valves-ops/gasoline-adulteration-detector/relatorio.pdf

# Universidade Federal de Santa Catarina

## Departamento de Engenharia Elétrica e Eletrônica

### EEL7837 - Projeto Nível I em Eletrônica II

# Detector de Gasolina Adulterada

Aluno | Vinícius D. Alves | 14100702

Professor Jefferson Luiz Brum Marques

21 de Setembro de 2020

## Conteúdo

1 Introdução | 1
2 Descrição do Projeto | 2
3 Fundamentação Teórica | 3
3.1 Fundamentos da determinação da composição de substâncias por proprie-
4 Projeto do Dispositivo | 7
4.2.2 | Redução do Impacto do Ruído de Quantização por meio de Elemen-
5 Resultados e Trabalhos Futuros | 21
6 Apêndice | 23
Referências | 27

## 1 Introdução

Estima-se que só em São Paulo 7% dos postos adulteram a gasolina que vendem [4]. Mesmo com uma fiscalização mais incisiva, os fraudadores ainda conseguem praticar o ato graças a adoção de tecnologias mais sofisticadas, como os chips que permitem de maneira remota a seleção entre a gasolina adulterada e a formulada [9]. Os danos provocados pela gasolina adulterada variam desde a perda de performance e dificuldade em partir o motor do carro até a corrosão e entupimento de componentes do sistema de injeção que podem causar grandes prejuízos para o proprietário do veículo [4]. Dado esse cenário, e a onda de combate a corrupção que tomou o país nos últimos anos, creio que munir o consumidor com uma tecnologia que o permita auditar a gasolina que compra de forma ágil e econômica seja a maneira mais eficiente, uma vez que não depende do Estado e de seus inumeráveis órgãos de fiscalização, de combater essa forma de corrupção praticada por postos de gasolina.
Dentre desse contexto, esse projeto tem como propósito o desenvolvimento do protótipo de um dispositivo capaz de efetuar a verificação do conteúdo de etanol de amostras de gasolina.

## 2 Descrição do Projeto

Objetiva-se por meio desse projeto a pesquisa, desenvolvimento e implementação do protótipo de um dispositivo portátil e de fácil uso que seja capaz de inferir o teor alcoólico de uma amostra de gasolina e, assim, determinar se essa encontra-se dentro dos requisitos da legislação.
O dispositivo explora a diferença de resistividade da gasolina e do etanol, o que implica em diferentes resistividades para soluções com diferentes proporções de etanol e gasolina. Para efetuar a medição da resistência da solução, o dispositivo é constituído por uma sonda de geometria padrão, o que torna as resistências medidas comparáveis, eliminandose a necessidade de calcular-se a resistividade a partir da resistência mensurada. Através da sonda citada, o fluído é excitado com uma tensão alternada gerada por módulo excitador e a diferença de tensão sobre o fluído é medida pelo módulo medidor. Esse, por sua vez, coleta amostras que são filtradas, processadas e alimentam uma função interpolante que descreve a relação entre a concentração volumétrica de etanol e a resistência medida. O resultado do cálculo da função é a concentração volumétrica de etanol da solução sob teste, que, quando comparado com o especificado na legislação, determina se a solução está ou não adulterada.
Para comprovar o funcionamento do dispositivo irá comparar-se o resultado de suas medidas com o procedimento clássico de extração da fase aquosa do sistema heterogêneo água-etanol-gasolina.

## 3 Fundamentação Teórica

### 3.1 Fundamentos da determinação da composição de substâncias por propriedades elétricas

A determinação da constituição de um material é feita a partir de suas propriedades intensivas [8], tais como densidade, dureza e índice de reflexão. No domínio eletromagnético, materiais podem ser caracterizados por propriedades como resistividade, permitividade e permissividade, isto é, ao medir-se a impedância de um material e calcular-se sua resistividade, permitividade e permissividade características, levando-se em conta sua geometria, é possível distinguir o material em questão de outros que apresentem diferentes características eletromagnéticas. Evidentemente que materiais podem compartilhar características eletromagnéticas e ainda sim serem classificados como materiais diferentes, sendo a diferenciação provocada por características num domínio diverso, tal como o mecânico ou o óptico.
Aplicações deste conceito podem ser encontradas nas mais diversas áreas da ciência, destacam-se dois exemplos: a mensuração da composição corporal através da bioimpedância e a inferência do conteúdo geológico do solo através do método da eletro-resistividade.
A técnica de bioimpedância explora a diferença de condutividade entre tecidos, isto é, tecidos com maior disponibilidade de eletrólito, como o tecido muscular, apresentam menor resistência elétrica enquanto tecidos adiposos, maior resistência. Além disso, também é explorada a diferença entre a característica do caminho intra e intercelular, sendo o primeiro caracterizado por apresentar um comportamento resistência e reatância capacitiva e o segundo, apenas resistência [3].
O método da eletro-resistividade, por sua vez, é um técnica da geofísica que utiliza um arranjo de eletrodos conectados a superfície do solo para produzir, através da mensuração da resposta ao transitório, uma imagem da subsuperfície, utilizada para estudo da composição do solo e investigação de lençóis freáticos [6][5].

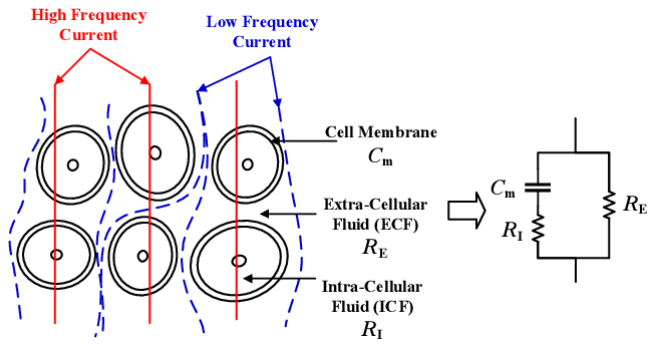
[picture p1: figure]

Figura 1: Modelo elétrico de tecidos celulares utilizado como base para a técnica de bioimpedância [7]

### 3.2 Impedância de Fluidos

Sendo a impedância a relação entre tensão e corrente dada a aplicação de uma tensão alternada em um meio, é possível, embora possa soar não-convencional, a ideia de impedância em um fluído. A impedância em um fluído é avaliada através da inserção de eletrodos que impõem uma tensão alternada no fluído que os circundam. A condução elétrica no fluido, que ocorre apenas em determinadas condições, pode ocasionar diversos efeitos que não são encontrados em sólidos.
Dado que a passagem em fluídos só ocorre mediante a presença de íons, ao se aplicar uma corrente contínua num fluído, atraindo-se os íons para os eletrodos, ocorre o fenômeno da eletrólise uma vez que os íons recebem/cedem elétrons para os eletrodos, incorrendo uma reação química que muda as substâncias ali presentes [12]. Como a mudança da substância sob medida é um efeito que impede a repetibilidade da medida e compromete o futuro uso da substância, a eletrólise é algo a ser evitado na medição da impedância em fluídos, o que implica na existência de uma frequência mínima de medição (dependente da característica elétrica do fluído e da geometria dos eletrodos) para que a medição não provoque eletrólise.
Por outro lado, fenômenos como a formação de uma camada elétrica dupla na interface entre os eletrodos e o eletrólito fazem com que esse apresente uma componente capacitiva. Numa modelagem simples, o fluído apresenta a característica de um circuito RC paralelo no qual a componente resistiva representa a resistência do substrato. Assim, ao desejar-se medir a componente resistiva, implica-se na existência de uma frequência limite para o qual os efeitos resistivos dominem os capacitivos. No artigo ’A simple impedance method for determining ethanol and regular gasoline mixtures mass contents’ [11] demonstra a existência de tais limites e os calcula a partir das características elétricas do fluido em questão para um transdutor com geometria similar a um cabo coaxial. O resultado encontrado foi o seguinte:
Efeito | Limites
Limiar de eletrólise do etanol | f ≤ 10 Hz

Dominância Resistiva
na solução etanol-gasolina f < 370 kHz

Dominância Capacitiva
na solução etanol-gasolina f > 3.7 MHz

Tabela 1: Limites de frequências por efeitos elétricos e no fluído

Nesse trabalho, como foi empregado um transdutor com geometria diferente da usada pelo artigo supracitado, utilizou-se testes empíricos para determinação da frequência de excitação do fluído, que foram posteriormente embasados nos fenômenos descritos acima. A determinação empírica observou que ao aplicar-se uma tensão continua notava-se que a diferença de potencial entre os eletrodos crescia com o tempo, indicando a existência de um componente capacitivo sendo carregado ao longo do período, que pode ser um efeito causado pela eletrólise da solução. Ao testar-se uma excitação com tensão alternada, percebeu-se que o efeito era reduzido e, portanto, aumentou-se a frequência até o ponto no qual o efeito de aumento da tensão desaparecesse completamente. A frequência encontrada empiricamente foi de 312.5Hz, estando essa no intervalo teórico previsto de 10Hz a 370kHz para soluções de etanol e gasolina.

### 3.3 Conversão Analógico-Digital

A conversão analógico-digital é o processo de conversão de um sinal analógico, caracterizado por ser continuo no tempo e em amplitude, num sinal digital, discreto no tempo e discreto em amplitude. Em outras palavras, a conversão analógico-digital transforma uma grandeza física num determinado momento em um número digital representando a magnitude dessa grandeza naquele momento do tempo.
A conversão analógico-digital ocorre em duas etapas: a amostragem e a quantização. A amostragem é a captura e congelamento da amplitude do sinal analógico por determinado período de tempo, o período de amostragem (figura 2.

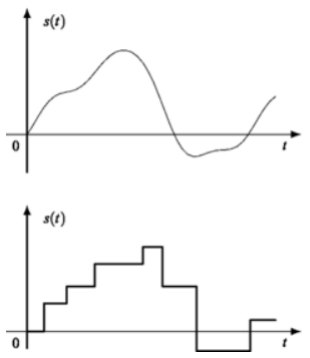
[picture p2: figure]

Figura 2: Representação da amostragem como ela ocorre no fisicamente no conversor analógico-digital, isto é, o congelamento periódico de níveis de tensão do sinal de entrada.

Durante esse período de tempo o conversor analógico executa a quantização da amplitude amostrada, a quantização é o processo de converter a amplitude para um número digital correspondente, isto é, associar a amplitude do sinal analógico, que pode assumir infinitos valores dentro de um determinado intervalo, com um valor valor finito específico pertencente à escala do conversor analógico-digital (figura 3).

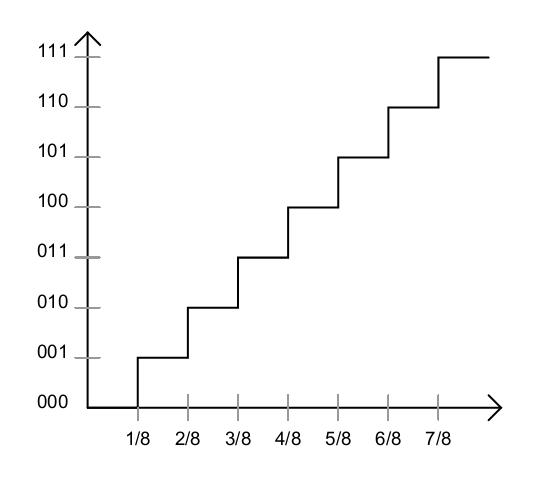
[picture p3: figure]

Figura 3: Representação da função executada pelo quantizador do conversor analógico digital, convertendo intervalos contínuos de amplitude num conjunto finito de números digitais.

No momento em que se efetua a associação de amplitudes que podem assumir infinitos valores dentro de um intervalo para um conjunto finito de representações, ocorre uma perda de informação, pois diferentes valores de amplitude do sinal analógico serão associados ao mesmo ponto da escala digital do conversor analógico-digital. Essa perda de informação pode ser descrita na forma de um erro, isto é, de um intervalo em torno do número obtido a partir da quantização. Esse intervalo representa o conjunto dos valores de amplitude do sinal analógico que podem ser associados indistintamente ao número digital em questão.
O erro de quantização é determinado diretamente pelas especificações do conversor analógico-digital, pois esse depende apenas de dois parâmetros: o intervalo que esse é capaz de mensurar o sinal analógico e a quantidade de pontos disponíveis na escala desse para associar as amplitude analógicas. No caso do ATMega328P, o conversor analógico digital opera no intervalo de 0 à 5V e possui resolução de 10 bits, isto é, representa números digitais com até 10 algarismos binários. Isso significa que o conversor apresenta 1024 (2¹⁰) pontos em sua escala e, portanto, o intervalo de amplitudes que é mapeado para um ponto específico é de aproximadamente 0.005 V , ou seja, toda tensão quantizada apresenta um erro de ±0.005 V .
O erro de quantização também pode ser interpretado como um ruído que é adicionado ao sinal durante o processo da quantização. Através dessa interpretação pode-se estimar o impacto da quantização no sinal resultante através do cálculo da relação sinal-ruído entre o sinal e o ruído de quantização. A relação sinal-ruído é diretamente proporcional ao quadrado do quociente da amplitude do sinal e da amplitude do erro, o que pode ser compreendido intuitivamente, uma vez que quanto menor o sinal sendo quantizado menos pontos na escala do conversor analógico-digital serão utilizados para representá-lo. Tomando-se como exemplo o conversor analógico-digital do ATMega328P, imagine um sinal senoidal com média e amplitude iguais à 0.005 V, a sua quantização resultaria na representação da amplitude do sinal por apenas dois números digitais distintos (0 e 1), o que é uma perda imensa de informação, visto que qualquer sinal não senoidal que apresente a mesma amplitude também seria reduzido a mesma sequência de número digitais que o sinal senoidal [10][1][2].

## 4 Projeto do Dispositivo

Em termos de arquitetura, o dispositivo é constituído por três principais componentes: o excitador, o medidor e um controlador. O bloco excitador é responsável por estimular o fluido com uma tensão alternada, enquanto o medidor efetua a medida da resposta resistiva do fluido (ignora-se a componente capacitiva uma vez que a frequência de excitação é escolhida de forma que a componente resistiva seja dominante). O controlador é responsável por controlar a excitação e efetuar a conversão analógico-digital da medição de forma sincronizada.

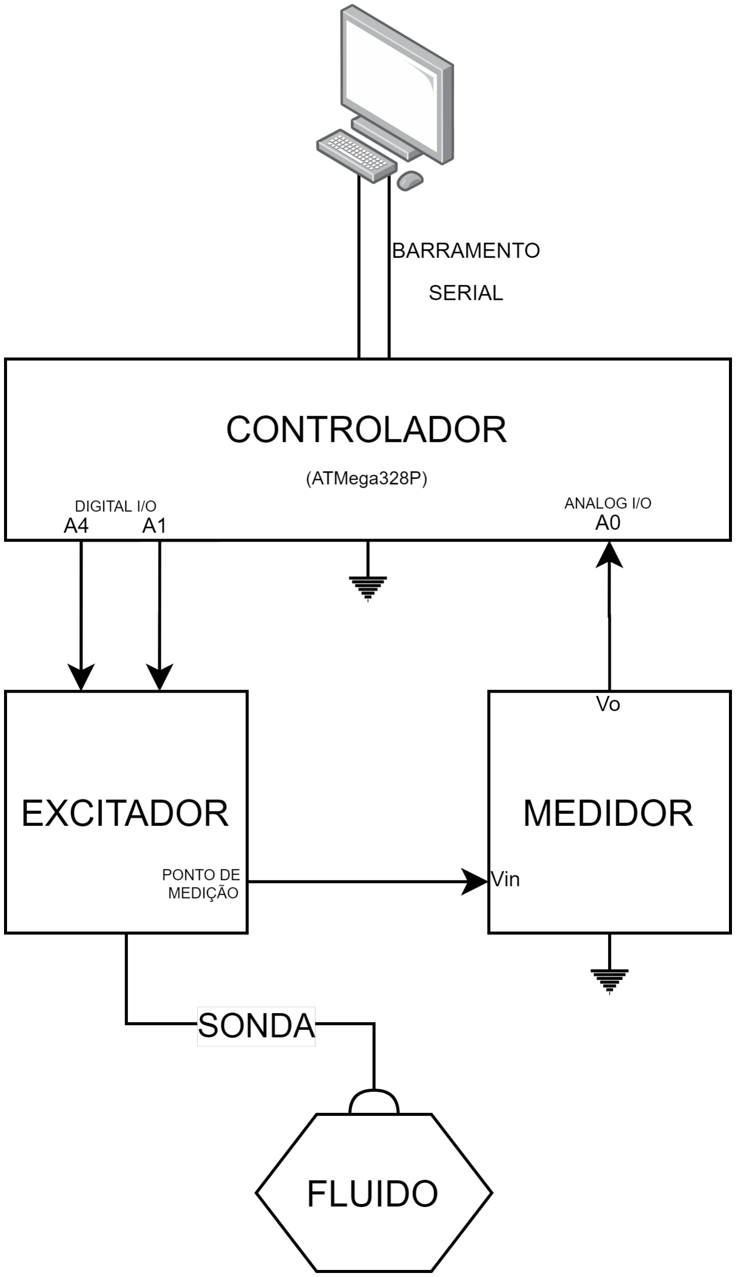
[picture p4: figure]

Figura 4: Arquitetura do Detector

### 4.1 Excitador

Idealmente o excitador deve estimular o circuito com uma tensão alternada sinusoidal de forma a evitar distorção do sinal ao atravessar o circuito RC paralelo formado pelo fluido. No entanto, como a frequência de excitação é selecionada de forma a tornar a presença do capacitor desprezível, isto é, apenas as harmônicas de alta ordem de um sinal não sinusoidal serão afetadas pela presença da reatância capacitiva.
Nesse contexto, a escolha de uma onda quadrada como excitadora é ideal por ser facilmente gerada a partir de um microcontrolador e por apresentar baixa energia nas harmônicas de alta frequência, tornando a distorção consequente também desprezível. Para gerar-se uma onda quadrada, basta ligar e desligar um pino digital de um microcontrolador em intervalos regulares de tempo, no entanto, para que essa onda seja alternada e não apenas pulsante nos eletrodos, é necessário que a referência alterne entre os eletrodos a cada ciclo. Para atingir esse efeito a excitação é feita através de dois pinos digitais, dessa forma, o eletrodo que na primeira parte do ciclo é ligado a alimentação (A4) por meio do ligamento do pino digital, na segunda parte do ciclo é ligado ao terra (GND) por meio do desligamento do pino digital. O resultado é uma onda quadrada alternada de amplitude igual à Vcc do ponto de vista de Rs, isto é, sendo A1 a referência (A1 GND), como mostra o diagrama abaixo.

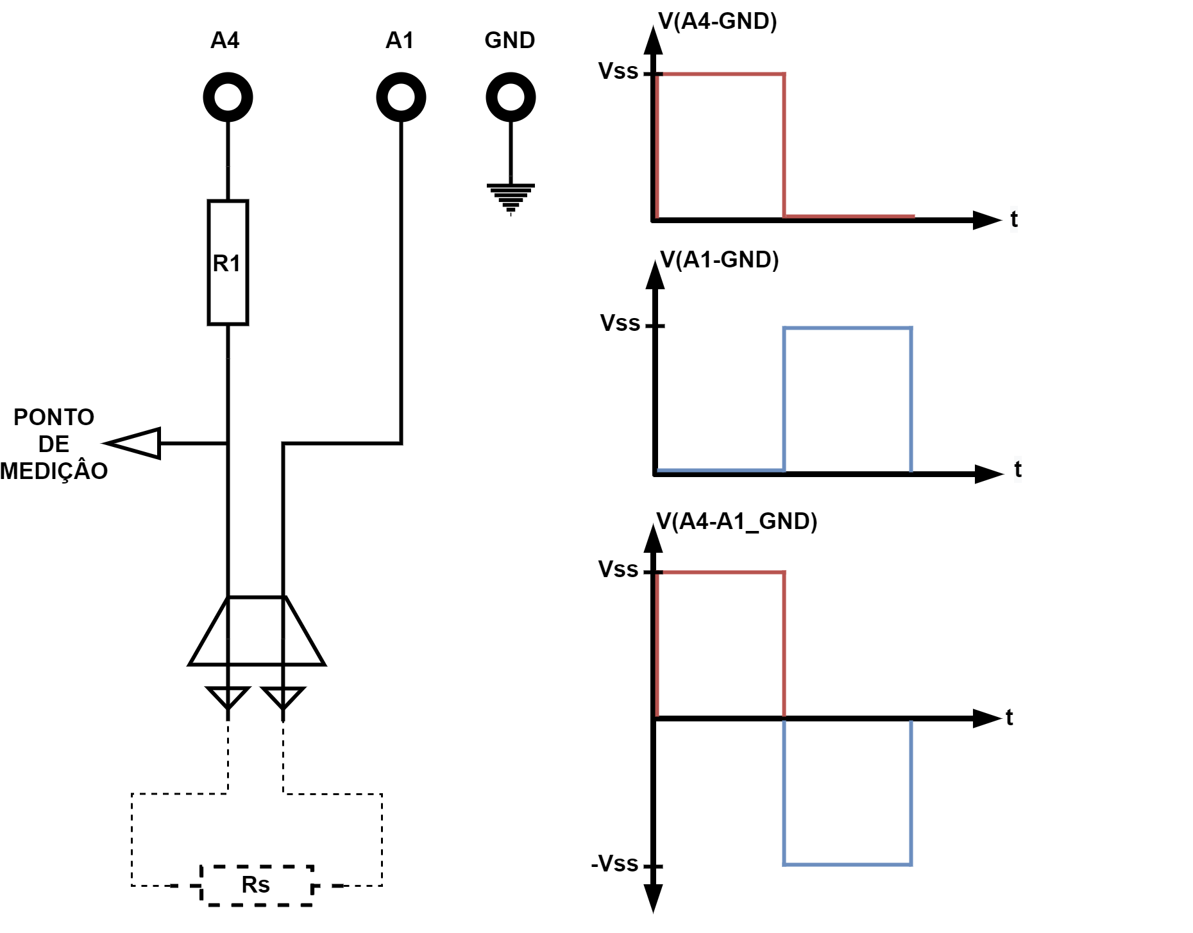
[picture p5: figure]

Figura 5: Circuito do Excitador e Excitação no domínio do tempo.
Nota: Vss na imagem é na verdade Vcc

Por fim, ao verificar-se que resistência da solução de gasolina e etanol é da ordem de centenas de milhares de Ohms, não se faz necessário a bufferização dos pinos A1 e A4, para que esses não sejam sobrecarregados pela corrente drenada pelo fluido. Portanto, o circuito final do excitador se resume ao mostrado no esquemático do diagrama 5.

### 4.2 Medidor

Para medir-se a resistência do fluído é necessário conhecer-se a diferença de potencial que esse está submetido e a corrente que o atravessa num determinado instante de tempo. No entanto, como conversores analógico-digitais mensuram apenas tensões, não é possível efetuar uma medida direta da corrente. Para contornar essa limitação é necessário o emprego de um divisor resistivo composto por uma resistência conhecida (R1) e a resistência que se deseja medir (o próprio fluido, denotado aqui por Rs). O divisor resistivo nos permite inferir a resistência desconhecida através da mensuração da tensão sobre o resistor conhecido (facilmente feito com um conversor analógico-digital), como é demonstrado abaixo:

Vo1 =

Rs
Rs + R1
Vcc | (1)

Vo2 =

R1
Rs + R1
Vcc | (2)

Rs = R1

Vo1

Vcc − Vo1

(3)

Rs = R1

(Vcc − Vo2

)
Vo2

(4)

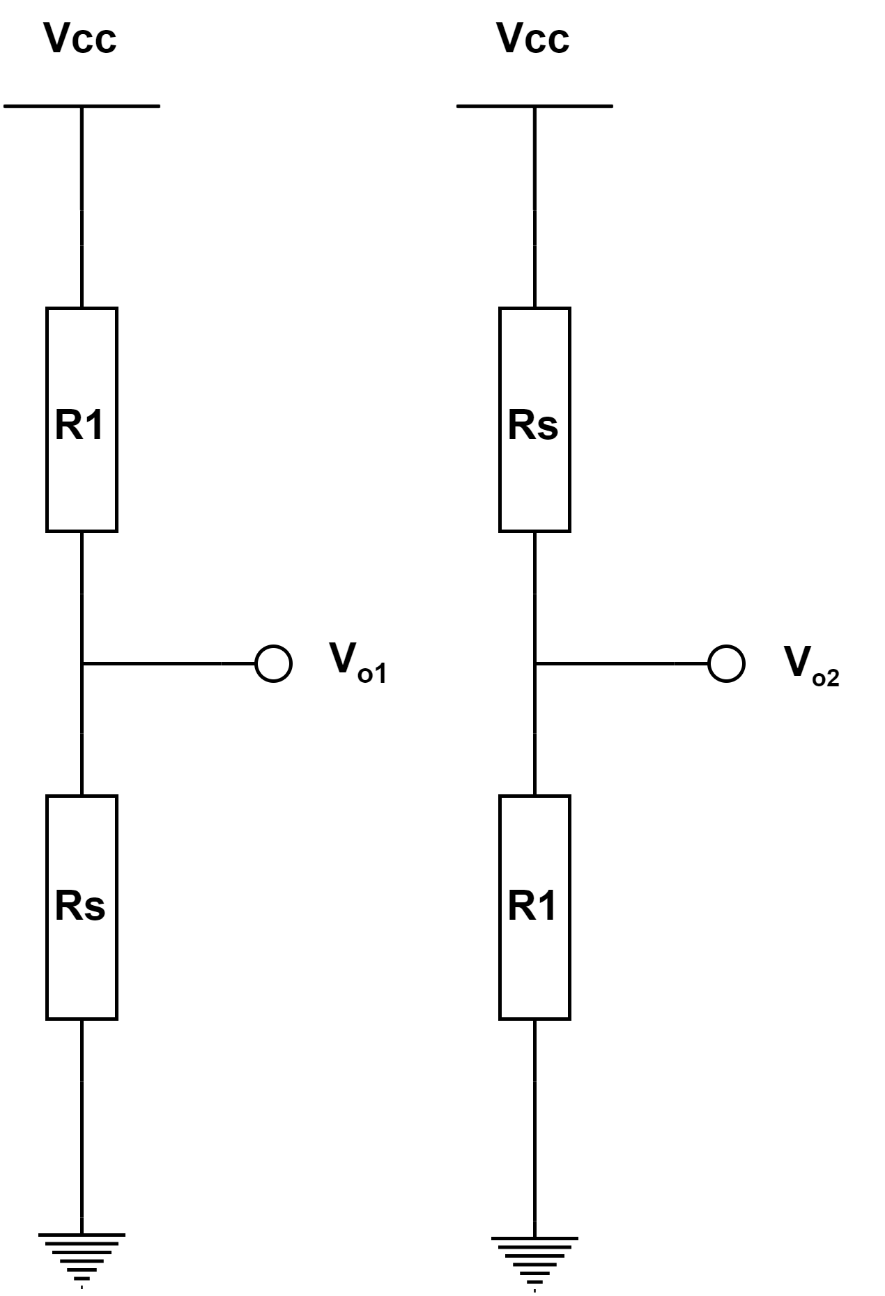
[picture p6: figure]

Figura 6: Divisores resistivos formados na primeira (Vo1

) e segunda
(Vo2

) parte do ciclo de excitação

Sendo o divisor resistivo o coração do sistema de medição, nas seções abaixo serão mostradas duas topologias baseadas no divisor resistivo que foram estudadas.

### 4.2.1 Divisor de Tensão Simples

O divisor de tensão puro pode ser utilizado diretamente para fazer-se a medição da resistência no fluido. Por ser extremamente simples, foi a primeira abordagem experimentada.
O único parâmetro de projeto é o valor da resistência de referência (R1). Ao analisarse as equações (1) (2), percebe-se que a escolha de R1 influência o intervalo de valores de queda de tensão que Rs poderá causar, isto é, se R1 >> Rs, a queda de tensão saturará para próximo de Vcc, enquanto que, se R1 << Rs, essa, saturará para o terra. Ou seja, durante a conversão analógico-digital, os valores de R1 muito próximos de Vcc ou do terra seriam quantizados como valores iguais, incorrendo-se na perda total da informação contida no sinal.
Se Rs fosse um valor constante, R1 = Rs, seria a escolha ideal, no entanto, como a razão entre álcool e gasolina na mistura é variável e, portanto, Rs é variável, R1 deve ser escolhido de tal forma que haja um compromisso entre não ser um valor muito abaixo do limite superior do intervalo de valores admitidos para Rs, nem um valor muito acima do limite inferior desse intervalo.
Dada a existência desse trade-off, busca-se encontrar um valor ótimo para R1 de forma a minimizar o impacto do erro de quantização na conversão analógico-digital, isto é, maximizar a relação sinal-ruido entre o sinal e o ruido gerado a partir do erro de quantização, dado que o erro do quantizador é fixo.
Portanto, sendo Vo e Eq a amplitude do sinal e do erro de quantização, temos que a SNR do sinal em relação é proporcional a:

SNR ∼

Vo
Eq

2
(5)

Como Eq é constante dado um conversor analógico-digital pré-determinado (e desconsiderandose a alteração da tensão de referência desse conversor (AREF no caso do ATMega328P),
temos que a maximização da SNR é proporcional a:

max SNR ∼ max V

2
o ∼ max Vo

max SNR ∼ max (Vomax − Vomin) ∼ max ∆Vo

(6)

Portanto, dado que:

Rs1 ≤ Rs ≤ Rs2
(7)

Temos que (considerando o circuito da figura 6):

∆Vo(R1) = VccRs2
R1 + Rs2

−

VccRs1
R1 + Rs1

(8)

Como Rs é externo ao circuito e Vcc é determinado pela tensão de alimentação do microcontrolador, temos que ∆Vo é passível de ser controlado apenas por R1, portanto, a maximização da SNR deverá ser feita com relação à R1:

max
R1

SNR ∼ max
R1

∆Vo(R1)

max
R1

∆Vo(R1) →

∂∆Vo(R1)
∂R1

= 0

(9)

Desenvolvendo-se a expressão (9), obtem-se que a resistência de referência que maximiza a SNR é dada por:

R1 =

p
Rs1Rs2

(10)

### 4.2.1.1 Dimensionamento do Resistor de Referência

Para dimensionar R1, portanto, é necessário a determinação dos valores limites de Rs, isto é, da solução de etanol e gasolina no intervalo de interesse. Para tal, foram confeccionadas amostras (figura 7) com diferentes concentrações de etanol no intervalo entre 27 a 32.7% de concentração de etanol. A concentração de etanol das amostras foi inicialmente verificada através do método de separação da fase aquosa, no entanto, notou-se que o erro de medida da proveta utilizada não era suficientemente baixo para que a verificação fosse feita com sucesso. Para contornar essa limitação, utilizou-se uma balança com precisão de 100 miligramas para determinar-se as quantidades de gasolina e etanol que utilizadas na confecção de cada amostra, dessa forma foi possível confeccionar-se amostras com precisão de pelo menos 140 microlitros.

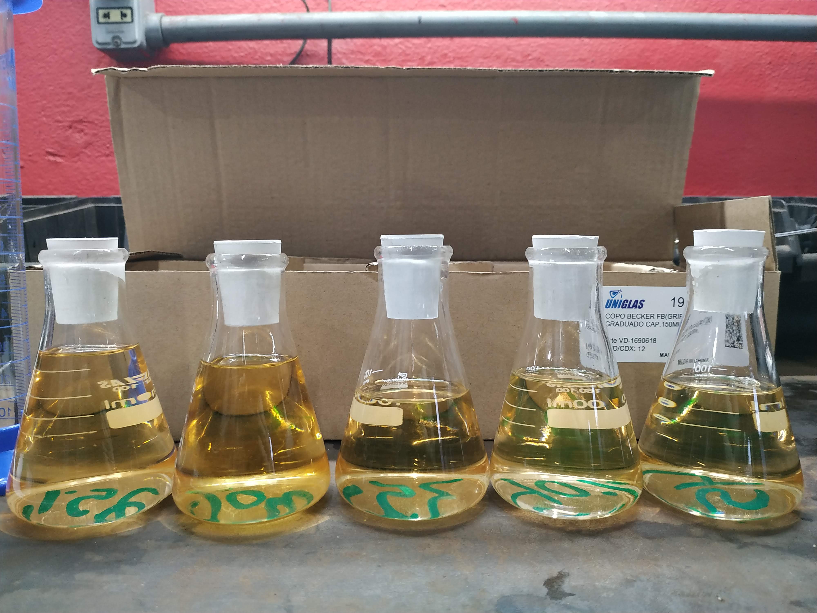
[picture p7: figure]

Figura 7: Amostras: soluções com diferentes concentrações de etanol na gasolina

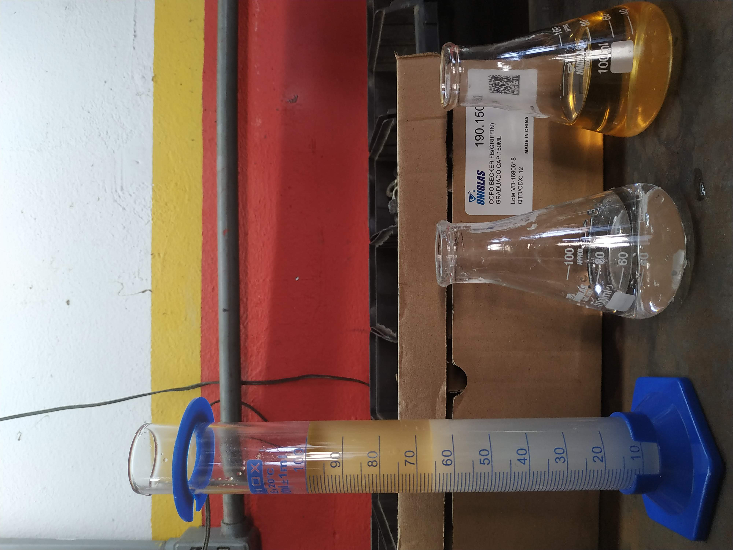
[picture p8: figure]

Figura 8: Mensuração da concentração de etanol pelo método da separação da fase aquosa

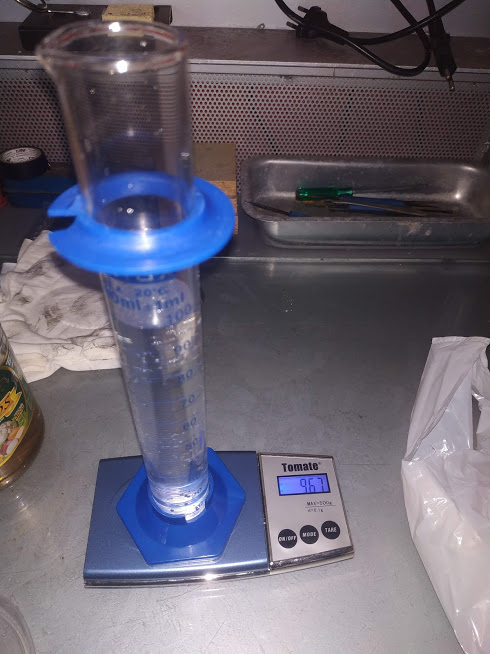
[picture p9: figure]

Figura 9: Balança de precisão utilizada para reduzir o erro da confecção das amostras de 1000 para 140 microlitros

A partir das amostras foram mensuradas as resistências que definem o intervalo para escolha do valor ótimo de R1.

Concentração
Volumétrica de Etanol

Resistência média medida com sonda padrão
27 % | 359.82 kΩ
28.6 % | 260.70 kΩ
30.0 % | 218.56 kΩ
31.7 % | 174.72 kΩ
32.7 % | 155.37 kΩ

Tabela 2: Diferentes resistências medidas a partir das amostras

Aplicando-se a equação (10) considerando os limites mensurados (Rs1 = 155.37 kΩ e Rs2 = 359.82 kΩ), temos que o valor ótimo de R1 para nossa aplicação é 236.44 kΩ. Dado os resistores disponíveis, optou-se por uma combinação de resistores resultando numa resistência equivalente de 200 kΩ, as custas de uma redução (desprezível) de 0.01V na amplitude máxima de Vo.

### 4.2.2 Redução do Impacto do Ruído de Quantização por meio de Elementos

Ativos

Mesmo escolhendo-se R1 de forma ótima percebe-se que a amplitude do sinal Vo não excursiona todo o intervalo de tensões permitido pelo conversor analógico digital, que vai de 0V à Vcc. Para aproveitar completamente esse intervalo de tensões, pode-se empregar um elemento ativo de forma a amplificar o sinal até que esse excursione de 0V à Vss. Porém, percebe-se também que uma mera amplificação não é suficiente para que o sinal excursione por todo o intervalo, visto que o valor mínimo de Vo é diferente de zero. Para contornar essa limitação é necessário que o elemento ativo, além de amplificar, também insira um offset negativo no sinal. Dessa forma, é necessário que o elemento ativo execute a seguinte função sobre o sinal:

Vo

0
= AVin − Vof fset | (11)

Sendo:

A =

Vcc

Vinmax − Vinmin

Vof fset = AVinmax − Vcc

(12)

### 4.2.2.1 Dimensionamento do Elemento Ativo

Optou-se pela utilização de um amplificador operacional TL084 na topologia de um subtrator (figura 10) para aplicação simultânea da amplificação e do offset no sinal de saída do divisor de tensão.

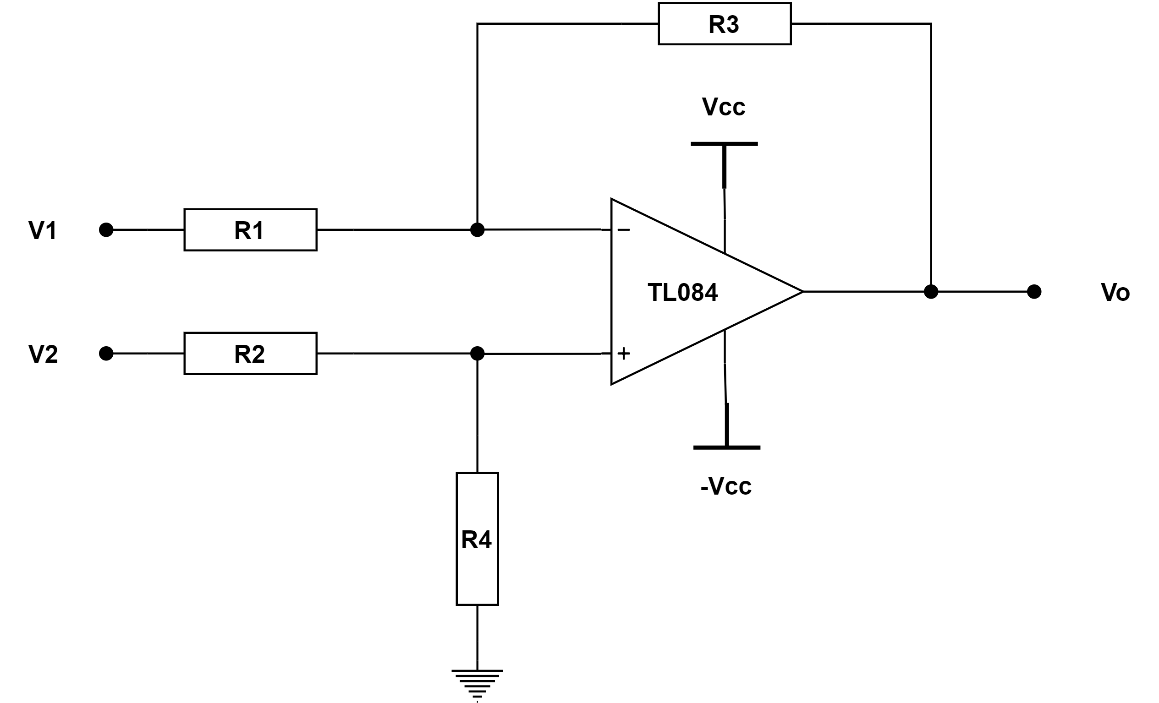
[picture p10: figure]

Figura 10: Topologia subtratora utilizada para aplicar um offset e amplificação no sinal de entrada

Como mostrado na equação (13), vemos que a relação entre o sinal de entrada e saída consiste na aplicação de um fator multiplicativo aplicado à R2 e um offset constituído por V1.

Vo = V2

R4
R2 + R4

! R1 + R3

R1

!
− V1

R3
R1

!
(13)

Dado o dimensionamento feito anteriormente para o resistor de referência, calcula-se, através das equações (1) e (2), que os limites de tensão para mensuração de soluções de gasolina com concentração de 27 a 32.7% de etanol, adicionados de uma margem de segurança de 0.2V para evitar saturação do conversor analógico digital, são 1,5 e 3,4V. Uma vez conhecida a tensão mínima e máxima de entrada temos que a amplificação e offset necessários para obtenção da quantização ótimas de acordo com as equações (12) são 2,63 e -3,95, respectivamente.
Para obtenção dos fatores de amplificação e offset calculados anteriormente, temos à disposição R1, R2, R3, R4 e V1 como parâmetros de projeto que estão relacionados a amplificação e offset do sinal de entrada pelas equações (14) e (15):

A =

R4
R2 + R4

! R1 + R3

R1

!
(14)

Vof fset = V1

R3
R1

!
(15)

Utilizando-se as expressões acima obtém-se o valor ideal dos parâmetros de projeto:

Parâmetro | Ideal | Comercial (Arranjo)
R1 | 1 kΩ | 1 kΩ
R2 | 3.14 kΩ | 3.3 kΩ
R3 | 2.458 kΩ | 2.5 kΩ
R4 | 10 kΩ | 10 kΩ
V1 | 1.61 V | 1.61 V
Tabela 3: | Valores ideais e aproximações comerciais para os
parâmetros do subtrator

### 4.2.3 Bufferização do Sinal de entrada

Como o ponto de medição (figura 5), isto é, o ponto no qual a entrada do medidor deve ser conectada, é a saída de um divisor resistivo, temos que sua impedância de saída não é nula. Além disso, a entrada do medidor (V2 na figura 13) não possui alta impedância, ou seja, a conexão direta do medidor ao ponto de medição resultaria num carregamento que altera as característica de ambos os circuitos. Devido a isso se faz necessário a introdução de um buffer na entrada do circuito de medição.
Para cumprir esse requerimento empregou-se um amplificador operacional configurado como seguidor de tensão, como esquematizado na figura abaixo.

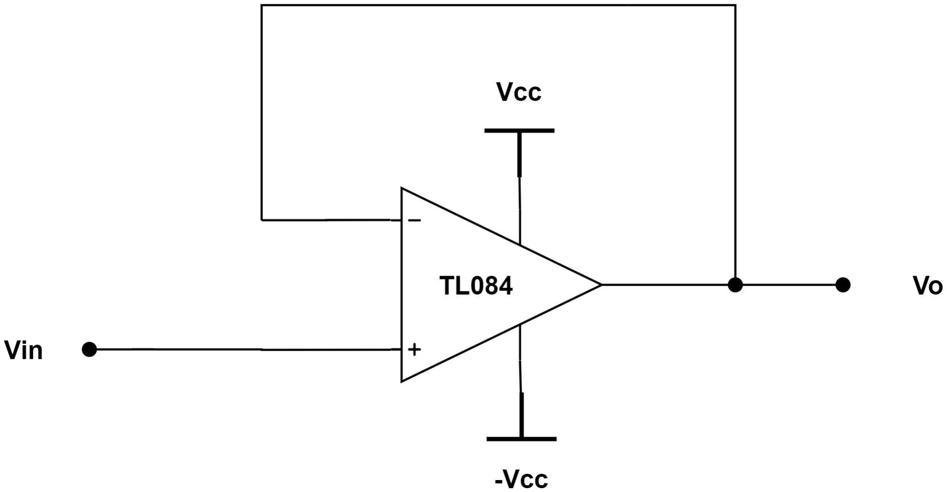
[picture p11: figure]

Figura 11: Seguidor de tensão

### 4.2.4 Tensão de Offset

Percebe-se que o offset aplicado pelo estágio de medição (Vof fset na equação (15)) é composto não apenas por um quociente de resistências mas pela tensão V1. Para geração dessa tensão tensão de referência empregou-se um divisor de tensão composto por resistência de alto valor com saída bufferizada, como mostrado na figura 12.

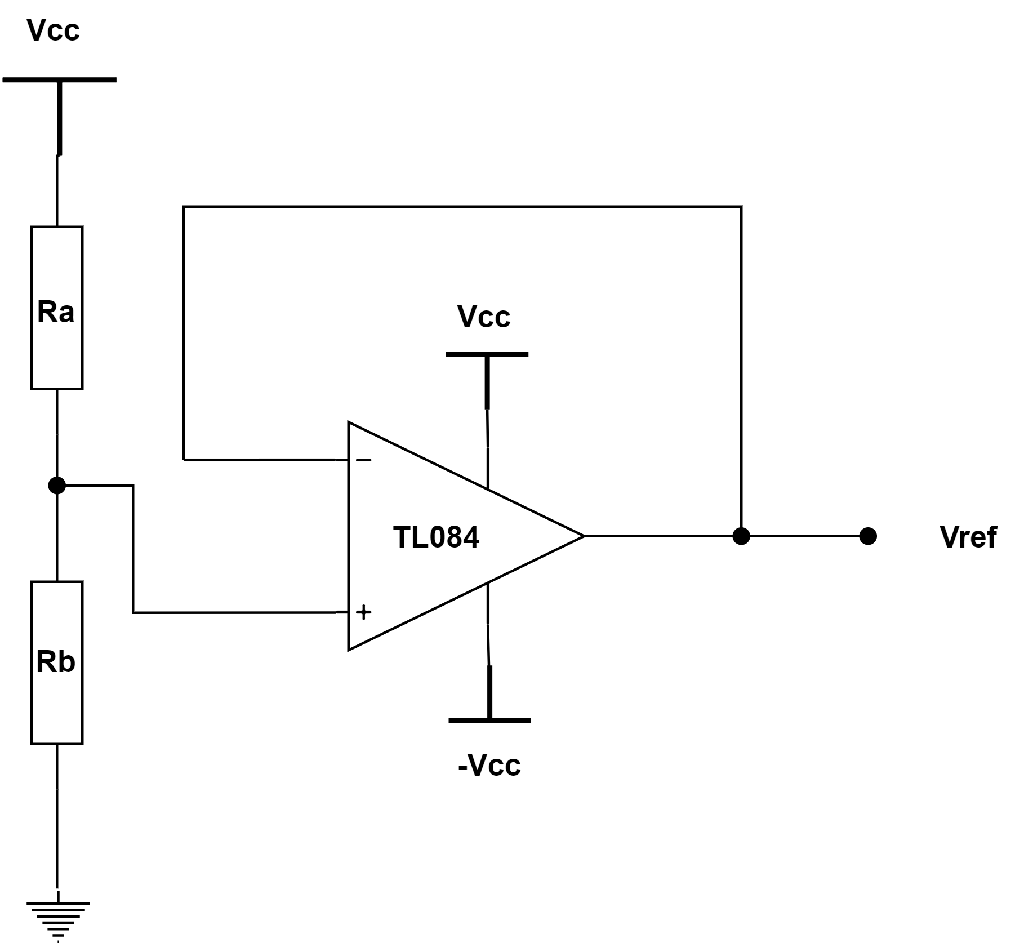
[picture p12: figure]

Figura 12: Circuito para geração tensão da tensão V1 do parâmetro

Vof fset

Na tabela abaixo é mostrado o resultado do cálculo dos parâmetros do circuito:

| Parâmetro | Valor | Comercial (Arranjo)
Parâmetros fixos | Vcc | 9.95 V | -
| Vref | 1.61 V | -
Parâmetros projetados | Ra | 51.7 kΩ | 51.7 kΩ
| Rb | 10 kΩ | 10 kΩ

Tabela 4: Parâmetros do gerador da tensão de referência V1

O emprego de resistências com alto valor é feito para que o caminho criado entre Vcc e o terra pelo divisor de tensão consuma uma baixa corrente, enquanto que a bufferização da saída evita o carregamento entre esse divisor de tensão e o estágio de medição.

### 4.2.5 Fonte Simétrica

Até então foram apresentados diversos blocos que compõe o estágio de medição e em todos eles o amplificador operacional está sendo alimentado por Vcc e −Vcc. Para gerar essa tensões simétricas foi empregado um amplificador operacional num encapsulamento separado (para que esse fosse alimentado por uma fonte não simétrica) na topologia exibida na figura 13.

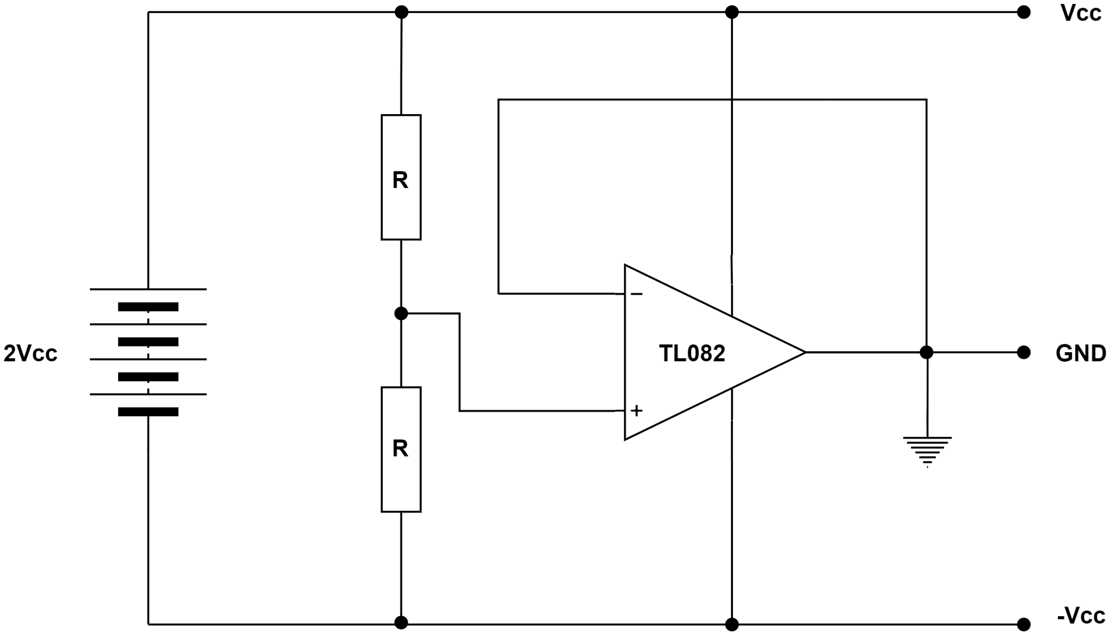
[picture p13: figure]

Figura 13: Fonte simétrica utilizada para alimentar os amplificadores operacionais do estágio de medição

O funcionamento da fonte simétrica independe do valor escolhido para o resistor R, mas como ambos resistores R formam um caminho fechado com a fonte, escolheu-se um valor arbitrariamente elevado para minimizar o consumo de energia, no caso, empregou-se resistores de 47 kΩ. Utilizou-se um amplificador operacional TL082 ao invés do TL084 pois o primeiro apresenta 2 amplificadores operacionais por encapsulamento enquanto o segundo, 4, reduzindo-se, assim, a quantidade de amplificadores operacionais desperdiçados.

### 4.2.6 Esquemático final do estágio de medição

Juntando-se todos os blocos, temos o esquemático final, onde Vin é o ponto de conexão com o ponto de medição do excitador e Vo onde o conversor analógico digital é conectado.

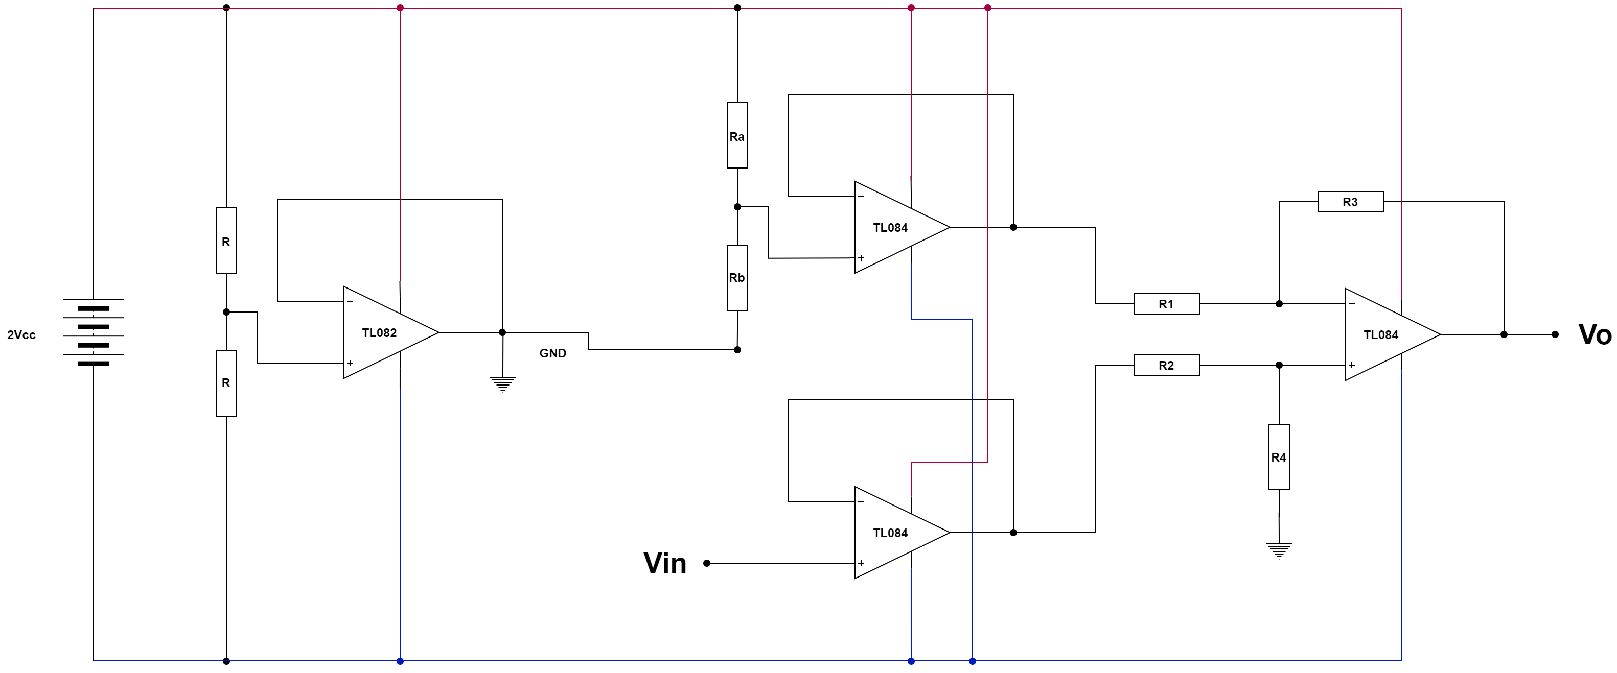
[picture p14: figure]

Figura 14: Fonte simétrica utilizada para alimentar os amplificadores operacionais do estágio de medição

### 4.3 Protótipo Final

O protótipo final foi construído com componentes discretos montados em protoboards, enquanto que o microcontrolador, por facilidade de gravação e comunicação serial, foi utilizado de forma embarcada em um Arduino, como mostrado na figura 15.

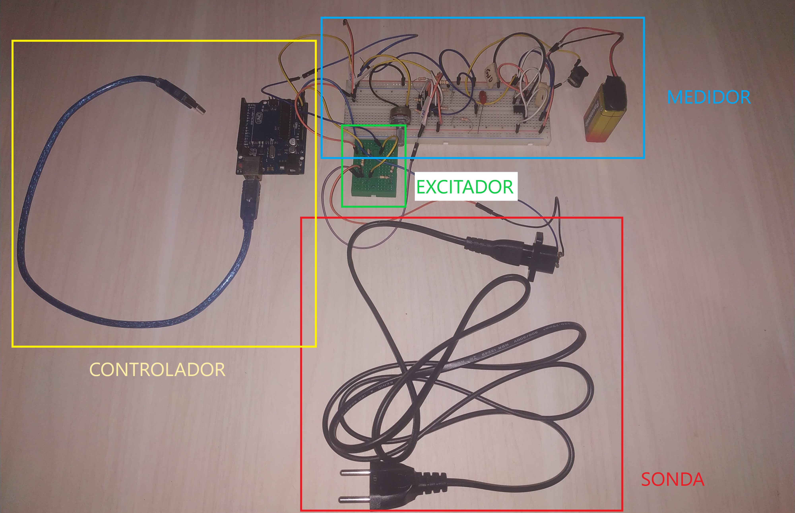
[picture p15: figure]

Figura 15: Circuitos prototipados com componentes discretos e protoboards

### 4.4 Processamento dos Dados

Uma vez obtida a diferença de potencial sobre o fluido em cada ciclo de excitação, é necessário filtrar e aplicar transformações nos dados de forma a extrair a informação sobre o volume de etanol dissolvido na mistura.
Com o objetivo de atenuar ruídos na medição oriundos de uma eventual heterogeneidade no fluído, movimentação da sonda de medição ou alguma interferência eletromagnética espúria, é possível utilizar-se de técnicas de processamento digital para mitigar o erro de estimação do conteúdo da solução.
Empregou-se o cálculo da média das amostras, análogo a um filtro digital passa-baixas, para estabilizar o resultado da medida. Empiricamente constatou-se que 300 amostras, isto é, o equivalente a uma média móvel simples dos últimos 300 elementos da série temporal, é suficiente para estabilizar a medida. A principal fonte de ruido detectada causando uma interferência significativa com o sinal medido foi a própria rede elétrica. Ruído que, pelos testes executados, é captado majoritariamente pelo longo fio que compõe a sonda.
Após a filtragem do sinal medido pelo conversor analógico-digital, transforma-se o valor obtido num valor de tensão multiplicando-se pela tensão de referencia do conversor analógico-digital, nesse caso 4.95V. Com a tensão calculada e sabendo-se o tipo de ciclo em que ela foi obtida, e possível calcular-se o valor da resistência do fluído através das formulas (3) e (4).
Uma vez conhecida a resistência do fluido, é possível inferir o conteúdo de etanol através de uma função obtida a partir da interpolação dos dados obtidos experimentalmente através da mensuração de amostras com conteúdo de etanol conhecido.
O processo de obtenção da curva interpolante é feito como parte da elaboração do algoritmo que será executado no microcontrolador, mas não é, em si, parte desse. Para obter-se a função interpolante utilizou-se as medidas feitas a partir das amostras confeccionadas na seção 4.2.1.1, pois através de tais amostras mede-se a resistência de diversas soluções de etanol-gasolina, de forma a estabelecer-se a forma da relação entre essas duas grandezas. Como visto na imagem abaixo (figura 16), a forma aparenta ser uma função exponencial decrescente.

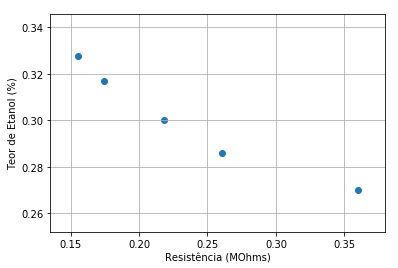
[picture p16: figure]

Figura 16: Resistência média das amostras

Uma vez conhecida essa forma, é possível determinar a classe da função interpolante para melhor modelar a relação entre as grandezas. E, uma vez determinada a forma da função interpolante, utiliza-se uma rotina de otimização para encontrar os parâmetros ideias para a função. Nesse caso especifico, dado que a forma aparenta ser uma exponencial decrescente, o que corrobora com os resultados obtidos em outros trabalhos, determinou-se a função especificada abaixo para servir de base para interpolação:

y = a + be−cx | (16)

Desenvolveu-se o script abaixo programado em Python, para determinar os parâmetros ótimos:

import numpy as np
from matplotlib.pyplot import plot from scipy.optimize import curve_fit

# Funç~ao interpolante

def curve(x, a ,b, c):
y = a + b*np.exp(-c*x)
return y

# Amostras para interpolaç~ao

x = np.array([np.mean([165.87, 144.87]), \ np.mean([177.8, 171.63]), \ np.mean([218.22, 218.9]), \ np.mean([263, 258.4]), \
np.mean([373.8, 345.84])])/1000 y = np.array([0.3276, 0.317, 0.3, 0.286, 0.27])

# Cálculo dos par^ametros

params, param_cov = curve_fit(curve, x, y) print(params)

Obteve-se os seguintes parâmetros ótimos para a função interpolante (tabela 5):

Parâmetro | Valor
a | 0.25579478
b | 0.24802099
c | 7.98099304

Tabela 5: Parâmetros ótimos

Por fim, o algoritmo executado pelo microcontrolador faz apenas o cálculo da função para o valor de resistência do fluido medido durante sua execução, como mostrado nos trechos de código abaixo:

// Par^ametros da Funç~ao Interpolante const float a = 0.25579478;
const float b = 0.24802099;
const float c = 7.98099304;
double e = 2.718281828459045235360287471352; //euler constant

//...

// Leitura crua do CAD na 1° parte do ciclo raw = raw/(num_samples/2);
// Leitura crua do CAD na 2° parte do ciclo
inv_raw = inv_raw/(num_samples/2);

VdropA = (Vin*raw)/1024.0; // Queda de tens~ao medida na 1° parte do ciclo VdropB = (Vin*inv_raw)/1024.0; // Queda de tens~ao medida na 2° parte do ciclo

// Remoç~ao do vies criado pela instrumentaç~ao
VdropA_r = (VdropA + offset)/A;
VdropB_r = (VdropB + offset)/A;

//...

// Cálculo do Rs
RsA_r = (R1*VdropA_r)/(Vin-VdropA_r); RsB_r = (R1/VdropB_r)*(Vin-VdropB_r); Rs_r = (RsA_R + RsB_r)/2;

//...

// Cálculo do Volume de Etanol
double vol_eth = a + b*pow(e, -c*(Rs_r/1000));

## 5 Resultados e Trabalhos Futuros

Após a finalização do protótipo executou-se uma série de medidas das amostras (tabela
6) a fim de determinar-se o desvio padrão da medida de teor alcoólico do dispositivo projetado. No curso das medidas notou-se que a posição da sonda em relação ao recipiente contendo a solução sob medida era a principal fonte de variabilidade nas medidas. Mais especificamente, notou-se que as medidas tendiam a agrupar-se em dois clusters, um formado por medidas com a sonda encostando no fundo do recipiente e outro formado por medidas com a sonda suspensa. Em todos os casos a sonda encontrava-se completamente submersa.
O desvio padrão médio estimado das medida de teor alcoólico foi de 0.64%, ou seja, isso significa que o dispositivo desenvolvido é capaz de determinar com 97.5% de confiança se uma mistura de álcool e gasolina apresenta adulteração de pelo menos 4.7% no teor de álcool, isto é, uma mistura adulterada com teor de álcool de 28.28% será detectada como adulterada em 975 de 1000 testes.
Embora o resultado tenha sido positivo e já apresente utilidade prática, acredita-se ser possível resultados ainda mais precisos visto que grande parte da variabilidade da medida parece ser oriunda de um não distanciamento padrão entre as paredes do recipiente e os eletrodos da sonda. Acredita-se que o acoplamento de uma gaiola protetiva em plástico resistente à gasolina resolveria tal problema e fica como sugestão para trabalhos futuros. Além disso, durante o curso do desenvolvimento do trabalho, enfrentou-se um problema de ’envelhecimento’ das amostras, isto é, com o passar do tempo (ou outro fator desconhecido) as amostras apresentaram resistividade decrescente, o que requereu a confecção de múltiplos conjuntos de amostras ao longo dos meses. Esse fenômeno oferece um grande desafio para medição de soluções cujo tempo de armazenamento é desconhecido, pois a curva de referência gerada a partir de amostras novas se torna inutilizável.
Por fim, desde a literatura é conhecida a influência da temperatura na resistividade das soluções de gasolina e etanol, portanto, um passo necessário para tornar esse protótipo mais robusto é a medição conjunta da temperatura e sua consideração no cálculo do teor alcoólico.

Concentração Volumétrica de Etanol Nominal

Medidas feitas
com sonda padrão Desvio Padrão

27 %

26.84%
27.00%
26.97%
27.43%
27.44%
28.57%
28.59%
27.15%
28.36%

0.67%

28.6 %

28.62%
28.73%
29.76%
28.81%
28.83%
29.2 %
29.21%
30.14%
30.00%

0.54%

30.0 %

29.93%
29.9 %
31.34%
30.08%
30.03%
30.25%
30.28%
31.9 %
31.42%

0.72%

31.7 %

31.58%
31.88%
33.16%
31.92%
31.9 %
32.7 %
32.72%
33.7 %
34.04%

0.82%

32.7 %

32.18%
33.38%
33.75%
32.8 %
32.78%
32.85%
32.86%
33.38%
32.61%

0.45%

Desvio Padrão Médio | 0.64%

Tabela 6: Medidas feitas para avaliação do erro padrão

## 6 Apêndice

### 6.1 Código do Controlador

1 | int ECPin= A0;
2 | int ECGround=A1;
3 | int ECPower =A4;
4 | float Vin = 4.95;
5 | int R1 = 200; // kOhm
6 | int num_samples = 100;
7 | int period = 2960; //+ 244us = 3200us
8 | double A = 2.63;
9 | double offset = 3.95;

10
11 | // RsxVol Curve coefs
12 | const float a = 0.25579478;
13 | const float b = 0.24802099;
14 | const float c = 7.98099304;
15 | //euler constant
16 | double e = 2.718281828459045235360287471352;

17
18 | void setup() {
19 | pinMode(ECPin,INPUT);
20 | //Setting pin for sourcing current
21 | pinMode(ECPower,OUTPUT);
22 | //setting pin for sinking current
23 | pinMode(ECGround,OUTPUT);
24 | digitalWrite(ECGround,LOW);
25 | digitalWrite(ECPower,LOW);
26 | Serial.begin(9600);
27 | Serial.println("Start Serial Comm");
28 | Serial.print("Using R1: ");
29 | Serial.println(R1);
30 | }

31
32 | void loop() {
33 | unsigned long time1;
34 | unsigned long time2;
35 | time1 = micros();
36 | double raw = 0;
37 | double inv_raw = 0;
38 | float Vdrop, VdropA, VdropB, VdropA_r
39 | float VdropB_r, Vdrop_inv;
40 | bool flag_cycle = true;
41 | for(int i = 0; i < num_samples; i++)
42 | {
43 | if (flag_cycle == true) {
44 | time1 = micros();

digitalWrite(ECPower,HIGH); delayMicroseconds((9*period)/10);
float holder = analogRead(ECPin);
// This is not a mistake, first reading will be low // because of charged a capacitor
raw = raw + analogRead(ECPin); delayMicroseconds(period/10); digitalWrite(ECPower,LOW);
time2 = micros();
flag_cycle = false;
} else {
digitalWrite(ECGround,HIGH); delayMicroseconds(period/2);
float holder = analogRead(ECPin);
int inv_read;
// This is not a mistake, first reading will be low // because of charged a capacitor
inv_read = analogRead(ECPin);
inv_raw = inv_raw + inv_read; delayMicroseconds(period/2); digitalWrite(ECGround,LOW); flag_cycle = true;

}

}

raw = raw/(num_samples/2); inv_raw = inv_raw/(num_samples/2);

VdropA = (Vin*raw)/1024.0; VdropB = (Vin*inv_raw)/1024.0;

VdropA_r = (VdropA + offset)/A; VdropB_r = (VdropB + offset)/A;

double Rs, RsA, RsB, Rs_r, RsA_r, RsB_r; RsA = (R1*VdropA)/(Vin-VdropA);
RsB = (R1/VdropB)*(Vin-VdropB);
Rs = (RsA + RsB)/2;

RsA_r = (R1*VdropA_r)/(Vin-VdropA_r); RsB_r = (R1/VdropB_r)*(Vin-VdropB_r); Rs_r = (RsA_r + RsB_r)/2;

bool debug = true;
if (Serial.available()) {
if (debug == true) {
Serial.print("VdropA: ");
Serial.println(VdropA);

93 | Serial.print("VdropB: ");
94 | Serial.println(VdropB);
95 | Serial.print("VdropA_r: ");
96 | Serial.println(VdropA_r);
97 | Serial.print("VdropB_r: ");
98 | Serial.println(VdropB_r);
99 | Serial.print("RsA_r: ");
100 | Serial.println(RsA_r);
101 | Serial.print("RsB_r: ");
102 | Serial.println(RsB_r);
103 | Serial.print("Rs_r: ");
104 | Serial.println(Rs_r);
105 | Serial.print("RsA: ");
106 | Serial.println(RsA);
107 | Serial.print("RsB: ");
108 | Serial.println(RsB);
109 | Serial.print("Rs: ");
110 | Serial.println(Rs);
111 | }
112 | double vol_eth = a + b*pow(e, -c*(Rs_r/1000));
113 | Serial.print("Vol. Etanol: ");
114 | Serial.println(vol_eth*100,2);
115 | if (vol_eth >= 0.2828) {
116 | Serial.println("GASOLINA ADULTERADA!");
117 | } else {
118 | Serial.println("GASOLINA N~AO ADULTERADA");
119 | }
120 | Serial.read();
121 | }
122 | }

### 6.2 Script para determinação do Desvio Padrão

# Medidas

medidas = np.array([curve(np.array([165.87, 144.87,139.14, 154.7, 154.89, \ 153.7, 153.66, 144.99, 158.03])/1000, *params), curve(np.array([177.8, 171.63, 148.6 170.92, 171.21, \ 156.3, 155.98, 139.92, 134.69])/1000, *params), curve(np.array([218.22, 218.9, 183, 213.88, 215.30, \ 209.12, 208.31, 171.32, 181.29])/1000, *params), curve(np.array([263, 258.4, 223, 255.34, 254.72, \ 241.08, 240.63, 212.32, 216.04])/1000, *params), curve(np.array([373.8, 357.96, 361, 325.01, 324.48, \ 265.02, 264.35, 345.84, 274])/1000, *params)])
# Cálculo do Desvio Padr~ao por amostra

stds = np.std(medidas*100, axis=1)

# Média do desvio padr~ao de todas as amostras avg_std = np.mean(stds)

## Referências

[1] Analog-to-digital converter. en. Page Version ID: 976907402. Set. de 2020. url: https : / / en . wikipedia . org / w / index . php ? title = Analog - to - digital _ converter&oldid=976907402 (acedido em 21/09/2020).
[2] ATMega328P Complete Datasheet. en. Page Version ID: 975088632. Ago. de 2020. url: https://www.waveshare.com/w/upload/9/93/ATmega328P_datasheet_Complete.pdf (acedido em 21/09/2020).
[3] Bioelectrical impedance analysis. en. Page Version ID: 958326300. Mai. de 2020. url: https://en.wikipedia.org/w/index.php?title=Bioelectrical_impedance_analysis&oldid=958326300 (acedido em 04/06/2020).
[4] Emily Nery Diogo de Oliveira. Combustível adulterado: danos silenciosos e irreversíveis ao automóvel - AUTO ESPORTE — Notícias. Fev. de 2019. url: https: //revistaautoesporte.globo.com/Noticias/noticia/2019/07/combustiveladulterado-danos-silenciosos-e-irreversiveis-ao-automovel.html (acedido em 14/08/2019).
[5] Electrical resistivity tomography. en. Page Version ID: 958067368. Mai. de 2020. url: https://en.wikipedia.org/w/index.php?title=Electrical_resistivity_tomography&oldid=958067368 (acedido em 04/06/2020).
[6] Geofisica Ambiental. url: https : / / www . iag . usp . br / siae98 / geofisica / geofambiental.htm (acedido em 04/06/2020).
[7] Bassem Ibrahim, Drew A. Hall e Roozbeh Jafari. “Bio-impedance spectroscopy (BIS) measurement system for wearable devices”. Em: 2017 IEEE Biomedical Circuits and Systems Conference (BioCAS) (2017). doi: 10 . 1109 / BIOCAS . 2017 . 8325138.
[8] Intensive and extensive properties. en. Page Version ID: 960408370. Jun. de 2020. url: https : / / en . wikipedia . org / w / index . php ? title = Intensive _ and _ extensive_properties&oldid=960408370 (acedido em 04/06/2020).
[9] Ramona Ordonez. Quadrilhas usam chips para alterar volume em bombas de combustível - Jornal O Globo. url: https://oglobo.globo.com/economia/quadrilhasusam - chips - para - alterar - volume - em - bombas - de - combustivel - 21518786 (acedido em 14/08/2019).
[10] Quantization (signal processing). en. Page Version ID: 975088632. Ago. de 2020. url: https://en.wikipedia.org/w/index.php?title=Quantization_(signal_processing)&oldid=975088632 (acedido em 21/09/2020).
[11] M Rocha e J Simoesmoreira. “A simple impedance method for determining ethanol and regular gasoline mixtures mass contents”. en. Em: Fuel 84.4 (mar. de 2005), pp. 447–452. issn: 00162361. doi: 10.1016/j.fuel.2004.09.011. url: https: //linkinghub.elsevier.com/retrieve/pii/S0016236104002790 (acedido em 21/09/2020).
[12] What Is Electrolysis — Reactions — Chemistry — FuseSchool. url: https://www.youtube.com/watch?v=7uIIq_Ofzgw&ab_channel=FuseSchool-GlobalEducation (acedido em 21/09/2020).
