valves-ops/gasoline-adulteration-detector/project_parameters_calculation.xlsx

Sheet: Resistência Referência
 | Limite Inferior (Ohm) | Limite Superior (Ohm) | Vss (V)
Rs | 155370 | 359820 | 4.95
R1 Otimo Teorico | 236442.8756
 | Ref | 200000
 | Vmax | 3.4
 | Vmin | 1.5
 | Vmax calc | 3.181574435
 | Vmin calc | 2.164171146
 | Vmin calc 2 | 1.768425565
 | Vmax calc2 | 2.785828854
 |  |  | 1.19
 |  |  | 2000000 | 632978.7234

Sheet: Projeto AmpOp
R1 | 1000 |  |  | A | 2.63 | Vcc | 9.95 | 10.6
R2 | 3101.507538 |  |  | Voffset | -3.95 | Rx | 51700 |  | 560
R3 | 2447.765141 |  |  | V1 | 1.61 | Ry | 10000 |  | 100
R4 | 10000
 |  |  | Real | Teorico
 |  | Vin | 1.5
 |  | Vout | 0.00 | 0.00

Sheet: Simulaçao AmpOp
R1 | 1000 |  |  | A | 2.63 | Vcc | 9.95 | 10.6
R2 | 3300 |  |  | Voffset | -3.95 | Rx | 51700
R3 | 2500 |  |  | V1 | 1.61 | Ry | 10000
R4 | 10000
 |  |  | Real | Teorico
 |  | Vin | 3.4
 |  | Vout | 4.92 | 5.00
 |  |  |  | Real A | 2.631578947
 |  |  |  | Real Voffset | 4.031604538
